VerticalHorizon/timetracker/(commit log)

2025-11-19 5 timetrackers, 2 countdowns. same font. too fast switch between tt & cd. TODO: increase font on cd, stable switch. fix cd default reset. add 3d cd(?)
    [timetracker_cgpt.ino]
2025-11-25 cycle countdowns. labels alignment. increased time font. 3 countdowns. factory presets for countdowns. FIX: countdowns adjustment when toggle tab on countdown tab
    [timetracker_cgpt.ino]
2026-03-05 fix: port to SH1106 128x64, refactor display constants
    - replace Adafruit_SSD1306 with Adafruit_SH110X (SH1106G controller)
    - replace tone() with ledc API (ESP32-C3 compatibility)
    - OLED_H, VISIBLE_ROWS, ROW_H вынесены в константы
    - remove duplicate if in countdown loop
    - AUTOSAVE_MS: 10s → 60s (reduce flash wear)
    [timetracker_cgpt.ino]
2026-03-05 Revert "fix: port to SH1106 128x64, refactor display constants"
    This reverts commit 161b5d51afee09f9cdff4d3c19bbd439a692dff6.
    [timetracker_cgpt.ino]
2026-03-05 Reapply "fix: port to SH1106 128x64, refactor display constants"
    This reverts commit 363f24a1c1943b5ef7ab5204b2187424c14365e4.
    [timetracker_cgpt.ino]
2026-03-05 fix: revert to SSD1306, set OLED_H=64 for 4-row display
    [timetracker_cgpt.ino]
2026-11-06 fix: port to SH1106 128x64 (Adafruit_SH110X)
    - display.begin() now takes (address, reset) per SH110X API
    - SSD1306_WHITE/BLACK -> SH110X_WHITE/BLACK
    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
    [timetracker_cgpt.ino]
2026-11-06 fix: swap NEXT/BACK long press on countdowns tab
    - BACK (long) now adds 5 min and NEXT (long) subtracts 5 min, matching the
    buttons' physical up/down position
    - ignore NEXT/BACK releases after both were held together: letting go after a
    tab switch no longer fires their short/long presses (e.g. C1 5:00 -> 6:00)
    - comments: translate the remaining Russian ones, fix typos and outdated notes
    (ESP32 Arduino core 3.x is required for ledcAttach())
    [timetracker_cgpt.ino]
2026-11-06 docs: add README with screen renders, .gitignore
    - README: idea, controls, parts, wiring, buzzer driver, build/flash steps,
    configuration, saved state, troubleshooting
    - docs/: pixel-accurate SVG renders of the trackers and countdowns screens
2026-11-07 feat: Bluetooth link and Android companion app
    - firmware v3.0: BLE GATT service (NimBLE-Arduino) advertising as "TimeTracker";
    publishes all timers about once a second, accepts "reset tracker" and
    "set countdown" (whole minutes)
    - trackers keep a never-reset total next to the shown time, plus a device id and
    a boot id, so the app counts task time without losing or double-counting it
    - BLE callbacks only queue commands; all timer state stays in loop()
    - android/: Kotlin + Jetpack Compose app with tasks, categories and countdowns;
    linking a task to a tracker resets that tracker, the task keeps its time
    and adds to it
    - unit tests for the time accounting, the protocol and the storage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
2026-11-07 fix: drive the OLED as an SSD1306
    - the module has an SSD1306 controller, not an SH1106: the SH1106 driver
    shifted the image two pixels to the right and never turned on the SSD1306
    charge pump, so the screen went dark after a power cycle
    - README: SSD1306 in the badge, parts list and libraries; troubleshooting
    tells the two controllers apart
    [timetracker_cgpt.ino]
2026-11-07 fix: drive the OLED as an SSD1306
    - same fix as on master: the SSD1306 library instead of SH110X, so the image
    isn't shifted and the screen survives a power cycle
    - README: SSD1306 in the badge, parts list, libraries and troubleshooting
    [timetracker_cgpt.ino]
2026-11-08 feat: use less power without changing behaviour
    - run the CPU at 80 MHz and idle between passes of loop(); a pass stays
    at 26 ms, because reading the buttons that far apart debounces them
    - send a frame to the screen only when it changed, plus every 5 s
    - advertise every 0.5-1 s and ask for a 100-200 ms connection interval
    once the app has subscribed
    - timers are unaffected: the tick reads the hardware clock and carries
    the remainder over
2026-11-08 docs: add a power and wiring diagram
    - docs/wiring.svg: battery pack, TP4056, switch, boost converter, ESP32-C3,
    OLED, buttons and buzzer driver, in light and dark
    - README: the diagram replaces the ASCII buzzer drawing; battery and power
    parts added to the hardware list and the pin table
